CyberCityCircuits/Kit_Dreamweaver_4N_Jr/DW 4N Jr Schematic.pdf

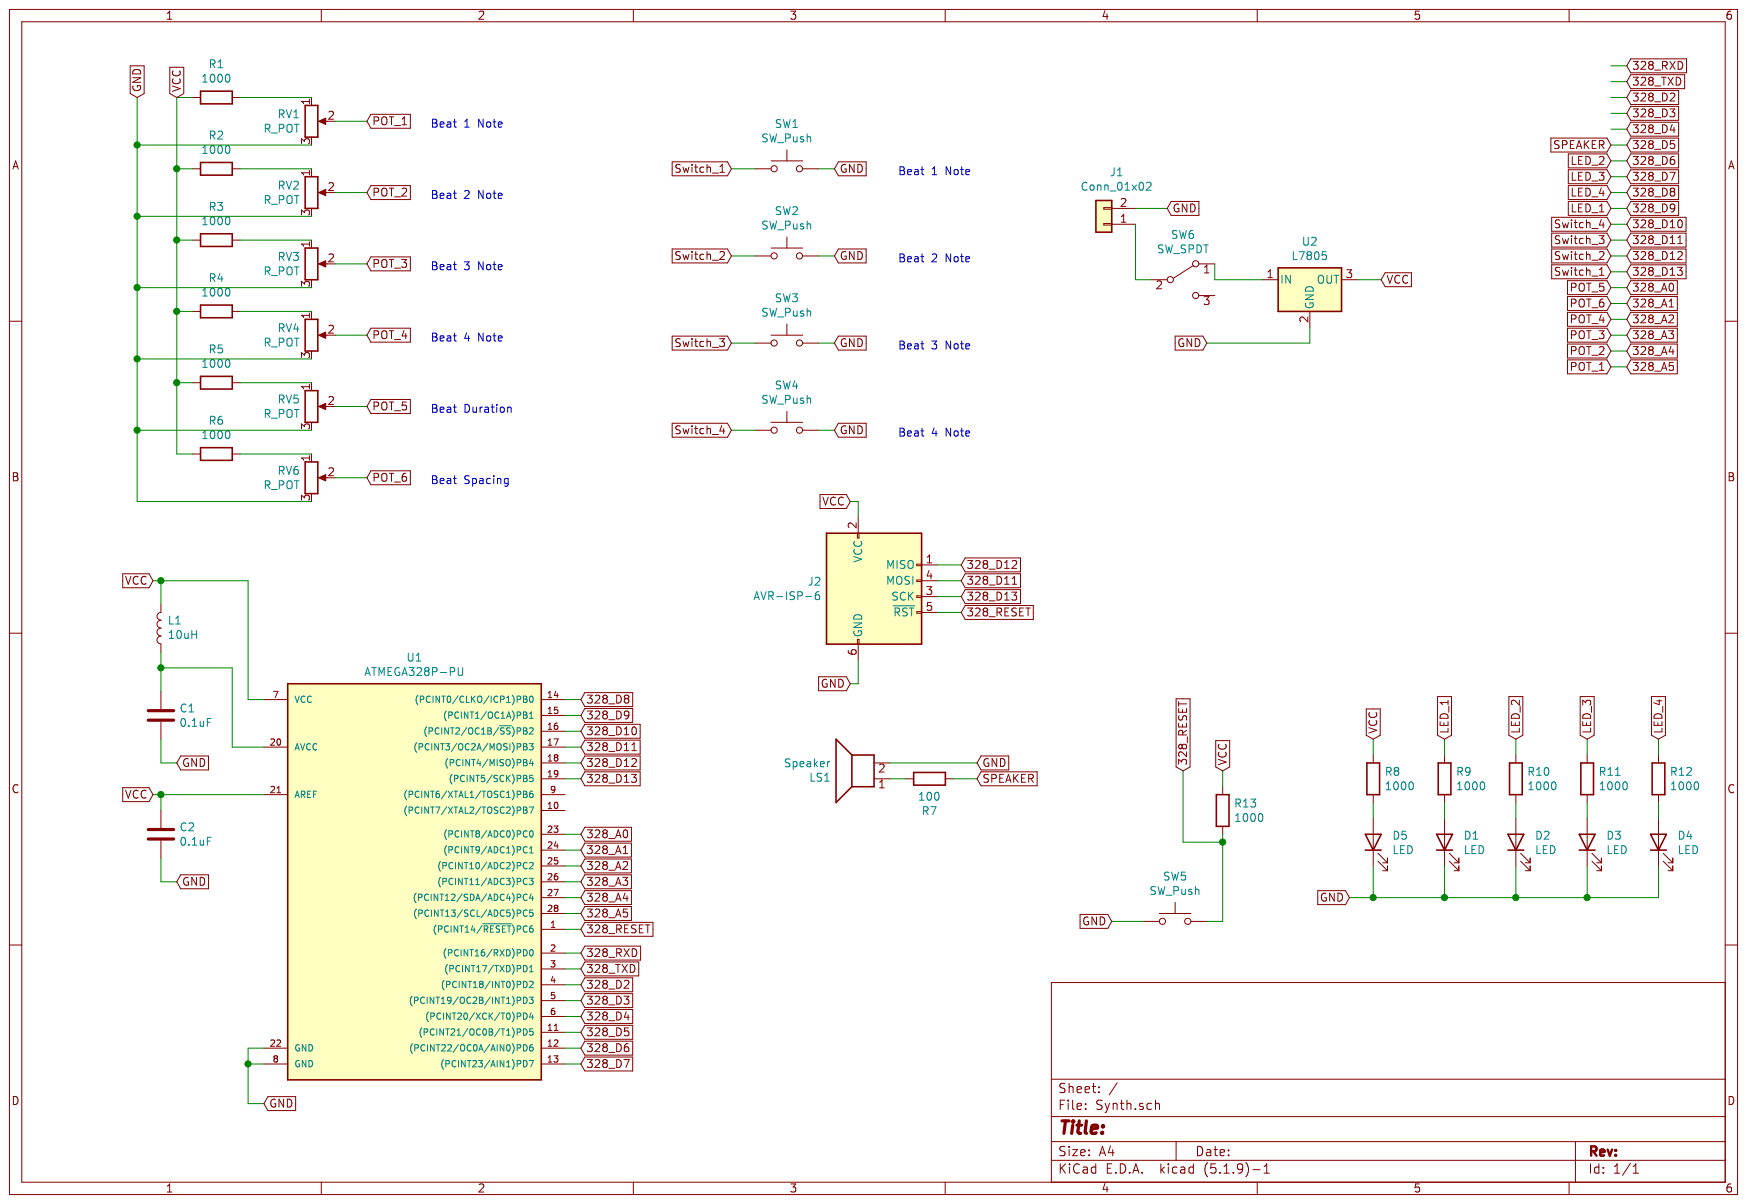
[picture p1: page 1]
