CyberCityCircuits/Kit_Dreamweaver_4N_Jr/Hardware/Synth.kicad_pcb

## KiCad design Hardware/Synth.kicad_pcb (2021-02-16)

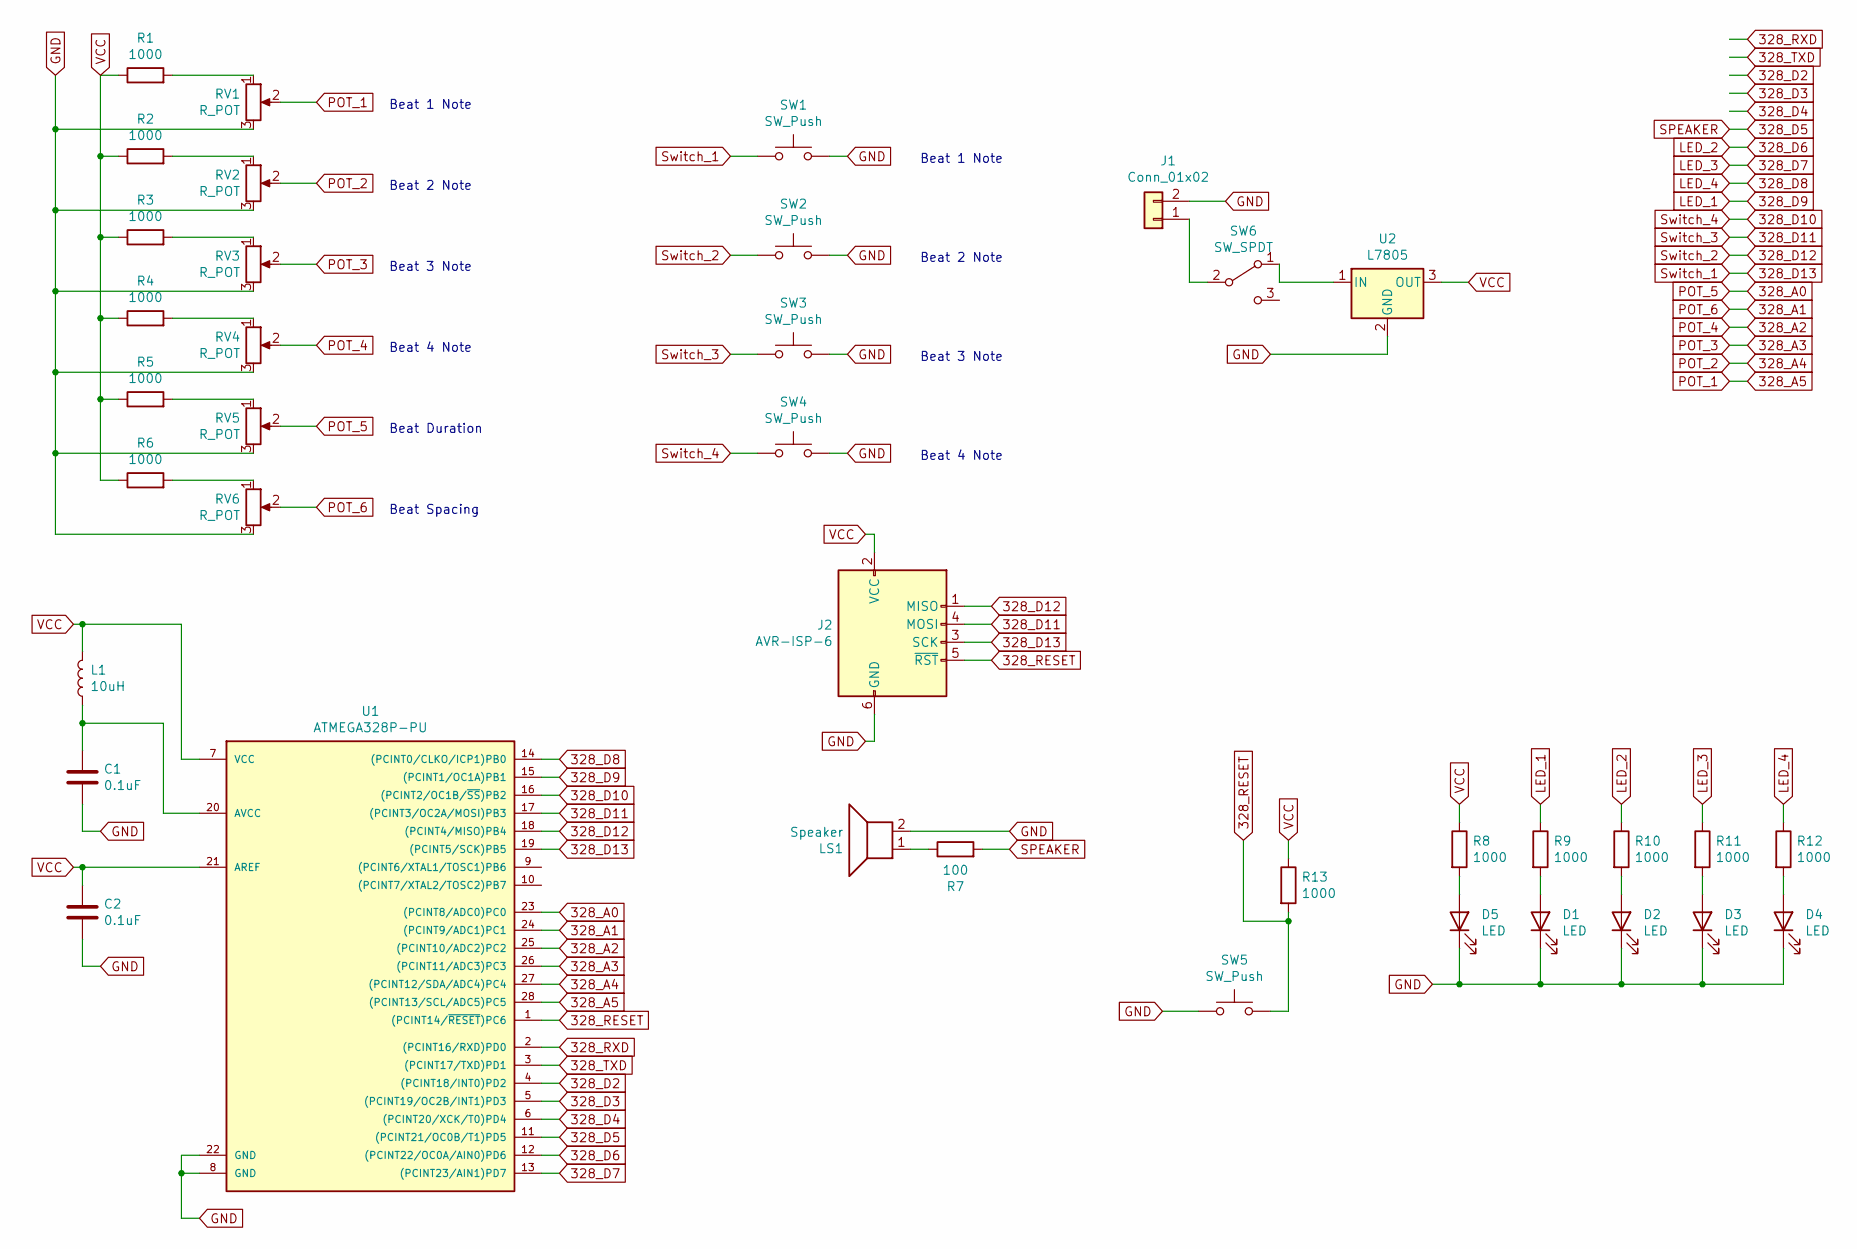
[picture p2: schematic Synth.sch]

Parts:
C1, C2: 0.1uF; Schematic - Capacitor 5.0mm
D1, D2, D3, D4, D5: LED; Schematic - LED 5mm(2.56P) 003
J1: Conn_01x02; 9V_Battery_Terminal
J2: AVR-ISP-6; PinSocket_2x03_P2.54mm_Vertical
L1: 10uH; Schematic - Inductor 10.16mm
LS1: Speaker; Speaker_Large_Fuet
R1, R2, R3, R4, R5, R6, R8, R9, R10, R11, R12, R13: 1000; Schematic - Resistor 7.62mm
R7: 100; Schematic - Resistor 7.62mm
RV1, RV2, RV3, RV4, RV5, RV6: R_POT; Potentiometer_Alps_RK09L_Single_Vertical
SW1, SW2, SW3, SW4: SW_Push; Schematic_-_Button_Labeled
SW5: SW_Push; Schematic - Push Button 6.5x4.5
SW6: SW_SPDT; PinHeader_1x03_P2.54mm_Vertical
U1: ATMEGA328P-PU; Schematic - ATMEGA328P-PU
U2: L7805; MOSFET_TO-220-3_Horizontal_TabDown

Connections:
328_A0: RV5.2, U1.23 ((PCINT8/ADC0)PC0)
328_A1: RV6.2, U1.24 ((PCINT9/ADC1)PC1)
328_A2: RV4.2, U1.25 ((PCINT10/ADC2)PC2)
328_A3: RV3.2, U1.26 ((PCINT11/ADC3)PC3)
328_A4: RV2.2, U1.27 ((PCINT12/SDA/ADC4)PC4)
328_A5: RV1.2, U1.28 ((PCINT13/SCL/ADC5)PC5)
328_D2: U1.4 ((PCINT18/INT0)PD2)
328_D3: U1.5 ((PCINT19/OC2B/INT1)PD3)
328_D4: U1.6 ((PCINT20/XCK/T0)PD4)
328_D5: R7.2, U1.11 ((PCINT21/OC0B/T1)PD5)
328_D6: R10.1, U1.12 ((PCINT22/OC0A/AIN0)PD6)
328_D7: R11.1, U1.13 ((PCINT23/AIN1)PD7)
328_D8: R12.1, U1.14 ((PCINT0/CLKO/ICP1)PB0)
328_D9: R9.1, U1.15 ((PCINT1/OC1A)PB1)
328_D10: SW4.1, U1.16 ((PCINT2/OC1B/~SS~)PB2)
328_D11: J2.4 (MOSI), SW3.1, U1.17 ((PCINT3/OC2A/MOSI)PB3)
328_D12: J2.1 (MISO), SW2.1, U1.18 ((PCINT4/MISO)PB4)
328_D13: J2.3 (SCK), SW1.1, U1.19 ((PCINT5/SCK)PB5)
328_RESET: J2.5 (~RST), R13.2, SW5.2, U1.1 ((PCINT14/~RESET~)PC6)
328_RXD: U1.2 ((PCINT16/RXD)PD0)
328_TXD: U1.3 ((PCINT17/TXD)PD1)
GND: C1.2, C2.2, D1.1 (K), D2.1 (K), D3.1 (K), D4.1 (K), D5.1 (K), J1.2, J2.6 (GND), LS1.2, RV1.3, RV2.3, RV3.3, RV4.3, RV5.3, RV6.3, SW1.2, SW2.2, SW3.2, SW4.2, SW5.1, U1.8 (GND), U1.22 (GND), U2.2 (GND)
unnamed: C1.1, L1.1, U1.20 (AVCC)
unnamed: D1.2 (A), R9.2
unnamed: D2.2 (A), R10.2
unnamed: D3.2 (A), R11.2
unnamed: D4.2 (A), R12.2
unnamed: D5.2 (A), R8.2
unnamed: J1.1, SW6.2 (B)
unnamed: LS1.1, R7.1
unnamed: R1.2, RV1.1
unnamed: R2.2, RV2.1
unnamed: R3.2, RV3.1
unnamed: R4.2, RV4.1
unnamed: R5.2, RV5.1
unnamed: R6.2, RV6.1
unnamed: SW6.1 (A), U2.1 (IN)
VCC: C2.1, J2.2 (VCC), L1.2, R1.1, R2.1, R3.1, R4.1, R5.1, R6.1, R8.1, R13.1, U1.7 (VCC), U1.21 (AREF), U2.3 (OUT)

Notes on the sheet:
Beat 1 Note
Beat 2 Note
Beat 3 Note
Beat 4 Note
Beat Spacing
Beat Duration

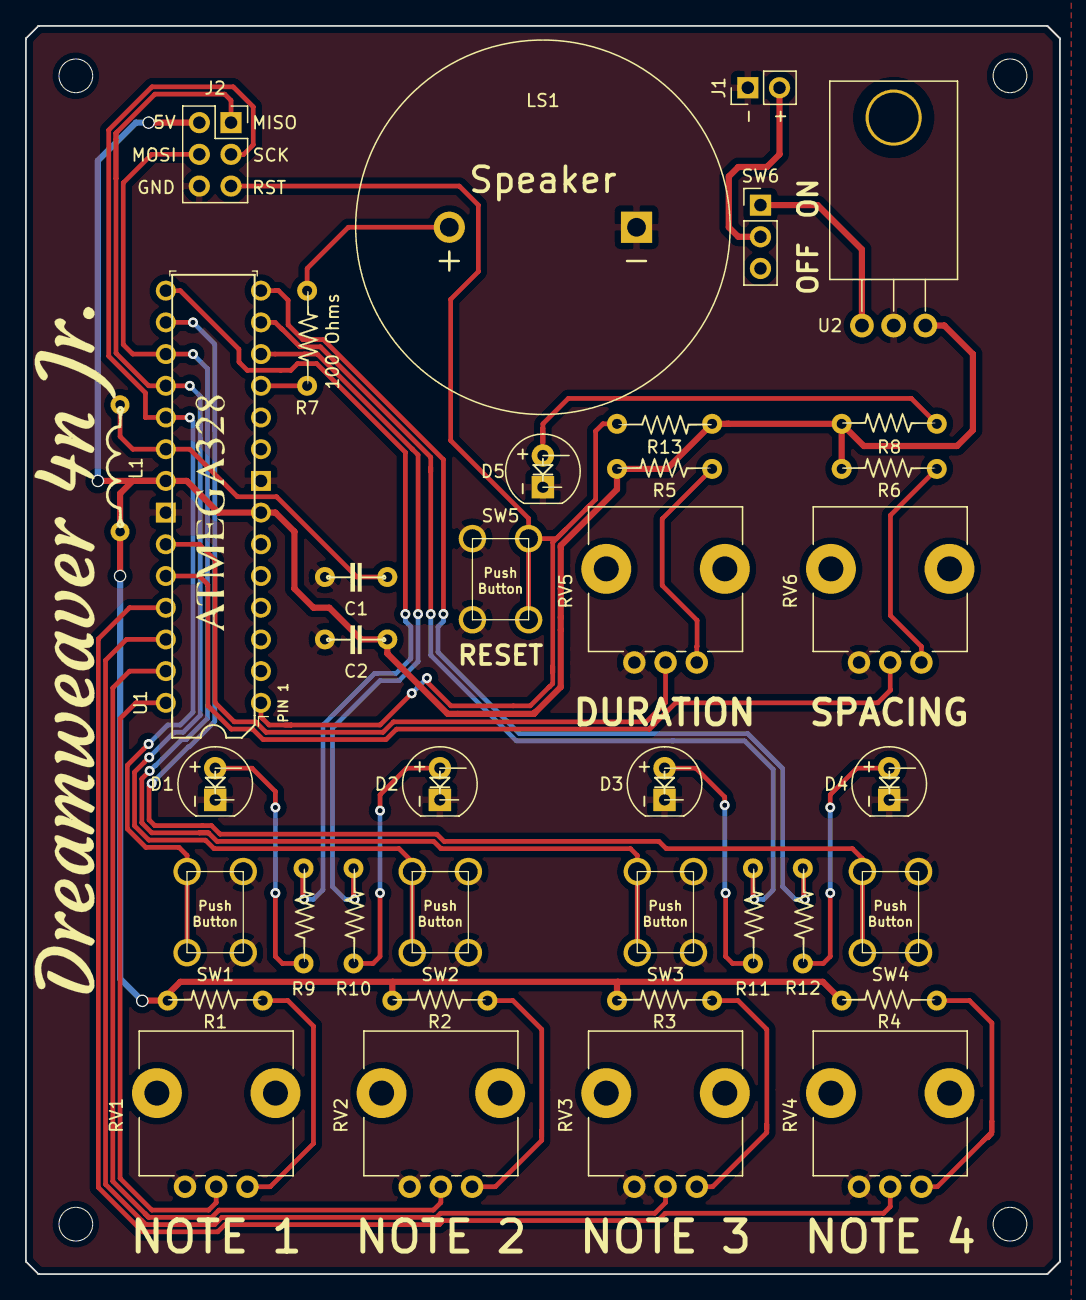
[picture p3: board Synth.kicad_pcb from above]

Board: 2 copper layers, 82.8 x 100.0 mm, 38 parts (0 on the bottom side), 33 nets.
